rdubois440/esp32_nunchuck_ble_keyboard/images/external-content.duckduckgo.com.jpeg

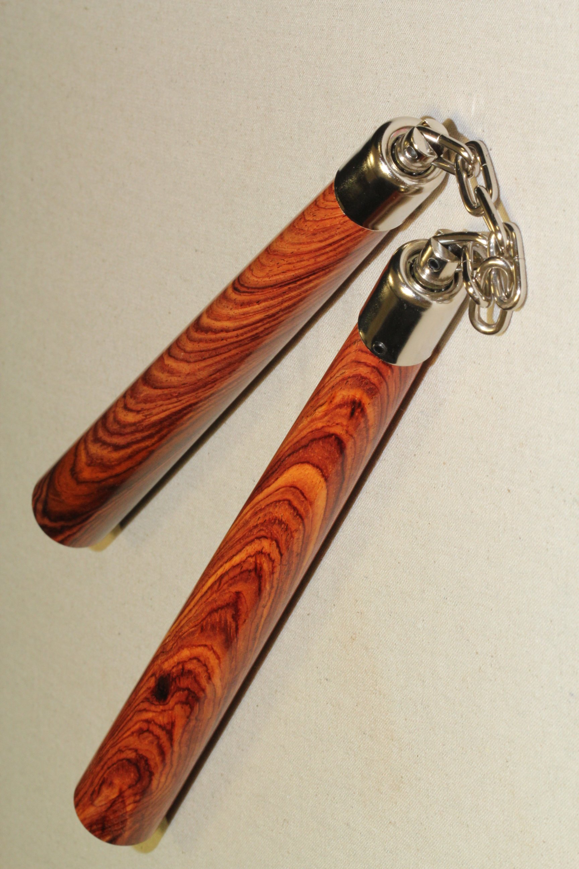
images/external-content.duckduckgo.com.jpeg
