rdubois440/esp32_nunchuck_ble_keyboard/images/Olimex_MOD-WII-UEXT.jpg

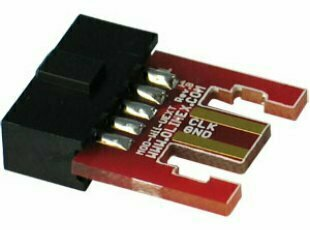
images/Olimex_MOD-WII-UEXT.jpg
